Victor-BM/PIBIC-CEFET/Mecânica/PROY_CASTER WHEEL FIXED 8 HEAVY DUTY/Render_Caster.JPG

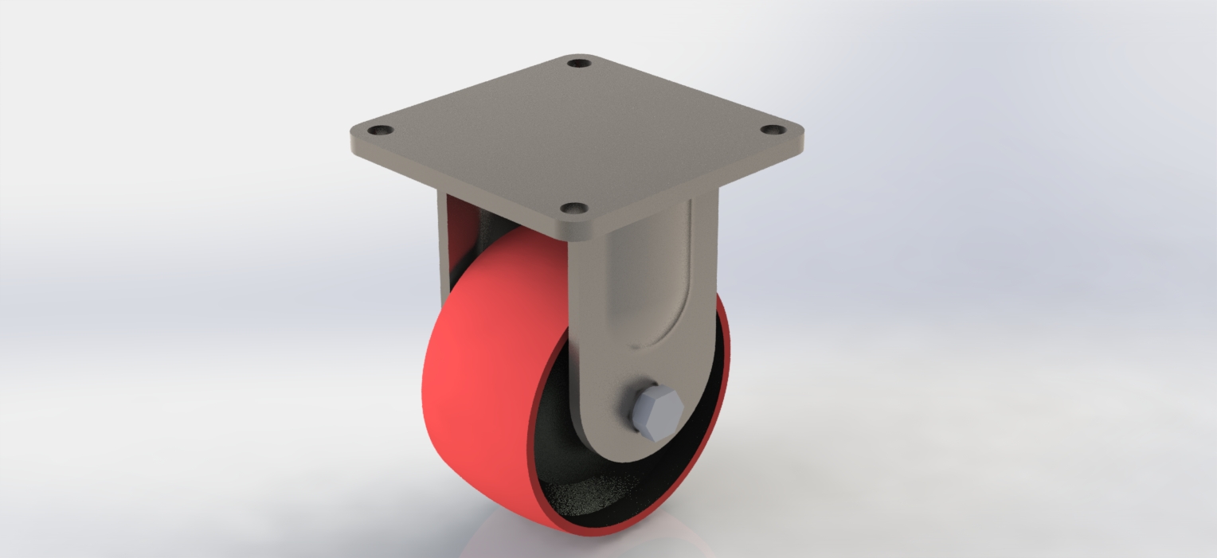
Mecânica/PROY_CASTER WHEEL FIXED 8 HEAVY DUTY/Render_Caster.JPG
