Victor-BM/PIBIC-CEFET/Mecânica/motorreductor v4.png

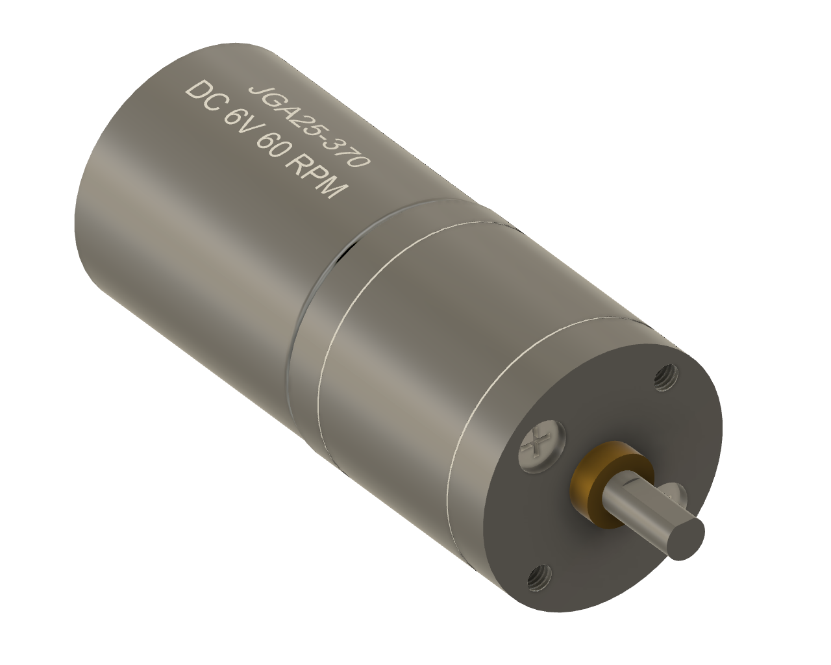
Mecânica/motorreductor v4.png
