Victor-BM/PIBIC-CEFET/Mecânica/motorreductor_1.png

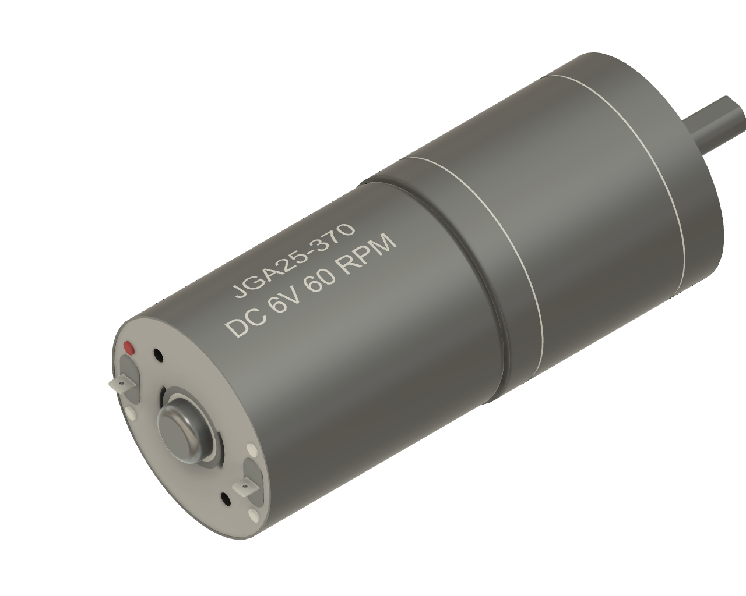
Mecânica/motorreductor_1.png
