Victor-BM/PIBIC-CEFET/Mecânica/PROY_CASTER WHEEL FIXED 8 HEAVY DUTY/Caster with 8.5 x 8.5 Plate.STEP

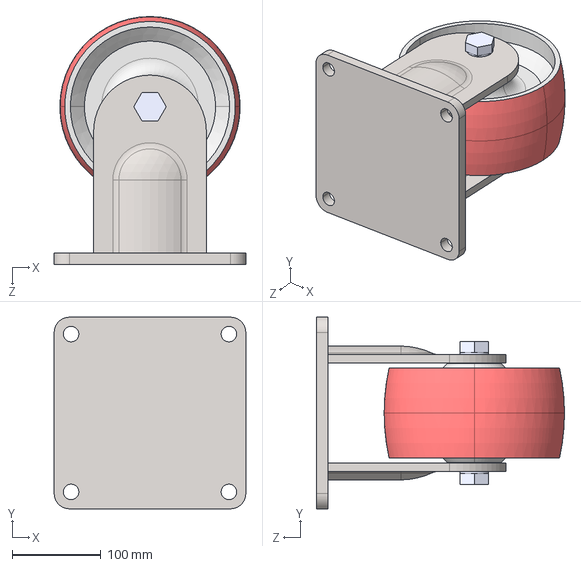
[picture p36: CAD file, 2023-12-13]
Mecânica/PROY_CASTER WHEEL FIXED 8 HEAVY DUTY/Caster with 8.5 x 8.5 Plate.STEP
215.9 x 215.9 x 279.4 mm
