Victor-BM/PIBIC-CEFET/Mecânica/servo motor (mg90s) .stl

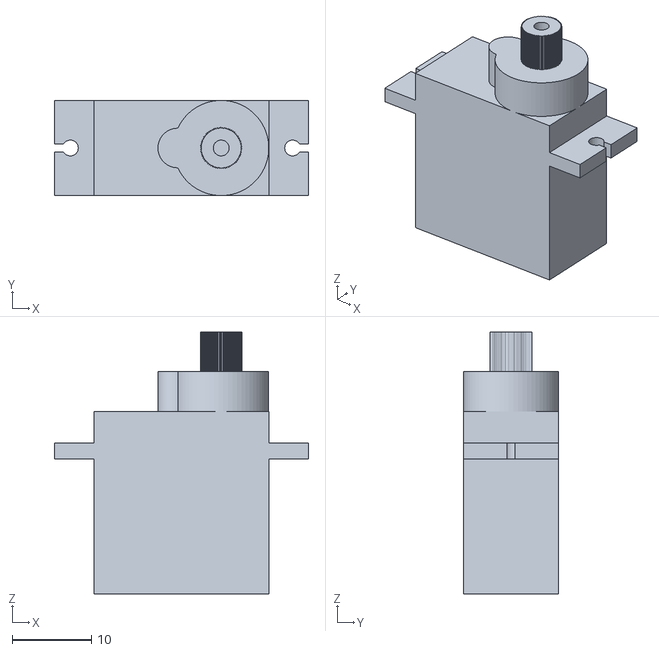
[picture p37: CAD file, 2023-12-13]
Mecânica/servo motor (mg90s) .stl
32.0 x 12.0 x 33.0
