Victor-BM/PIBIC-CEFET/Mecânica/wheel (scaled).SLDPRT

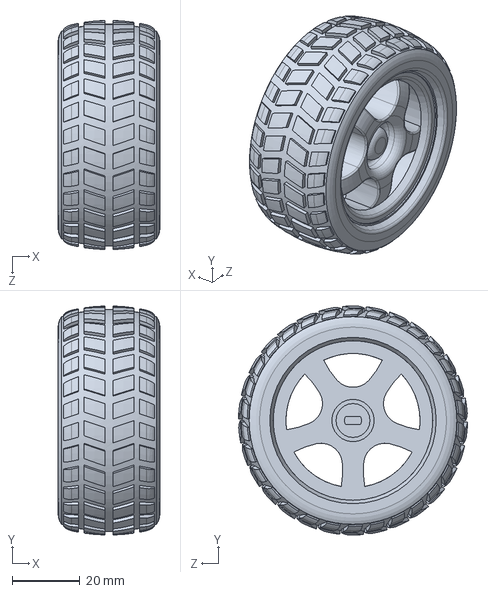
[picture p38: CAD file, 2023-12-13]
Mecânica/wheel (scaled).SLDPRT
30.0 x 67.4 x 67.5 mm
