Victor-BM/PIBIC-CEFET/Mecânica/shaft.SLDPRT

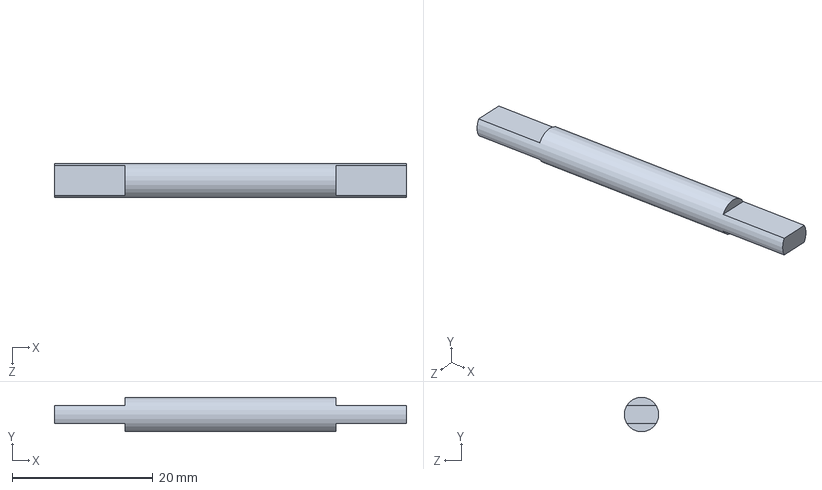
[picture p39: CAD file, 2023-12-13]
Mecânica/shaft.SLDPRT
50.0 x 4.90 x 4.90 mm
