Victor-BM/PIBIC-CEFET/Mecânica/GP2Y0A41SK0F.stp

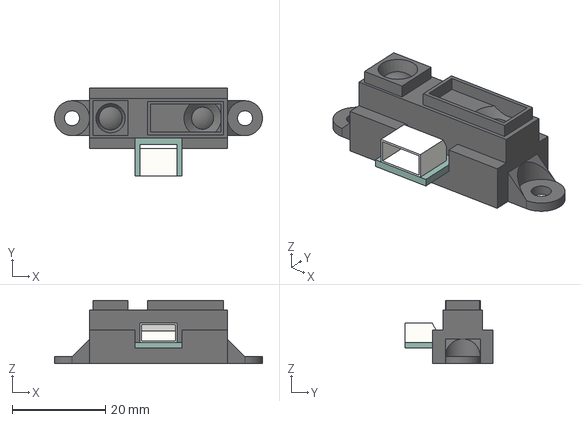
[picture p40: CAD file, 2023-12-13]
Mecânica/GP2Y0A41SK0F.stp
44.5 x 18.9 x 13.5 mm
