Victor-BM/PIBIC-CEFET/Mecânica/motor.SLDPRT

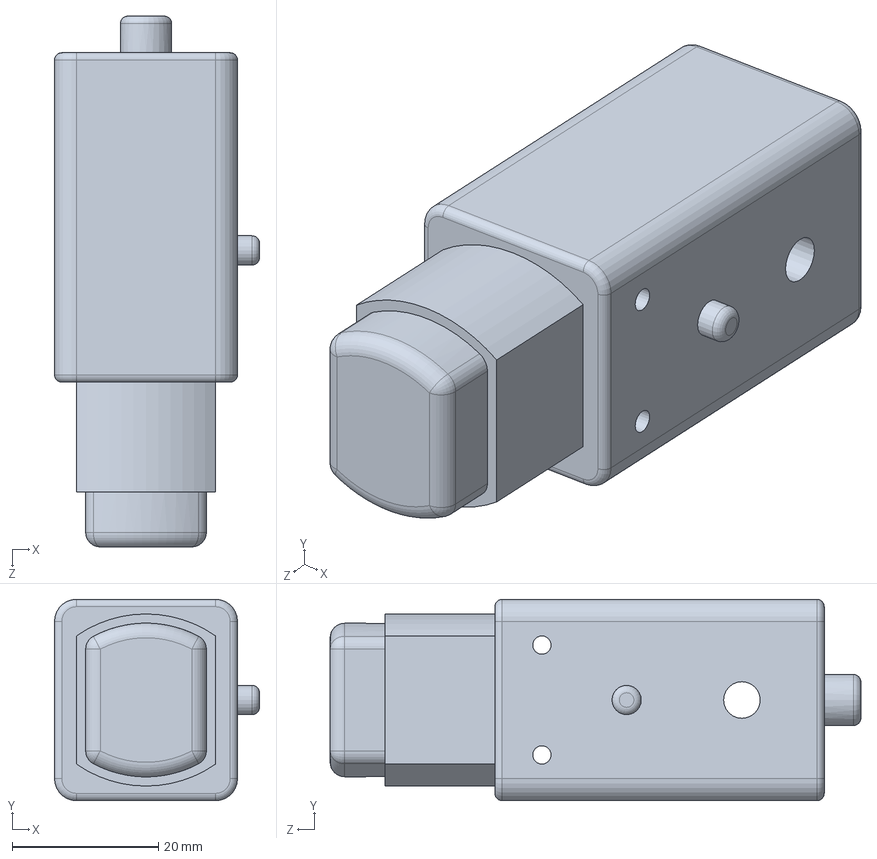
[picture p41: CAD file, 2023-12-13]
Mecânica/motor.SLDPRT
28.0 x 27.5 x 72.5 mm
