Victor-BM/PIBIC-CEFET/Mecânica/JGA25-370 .step

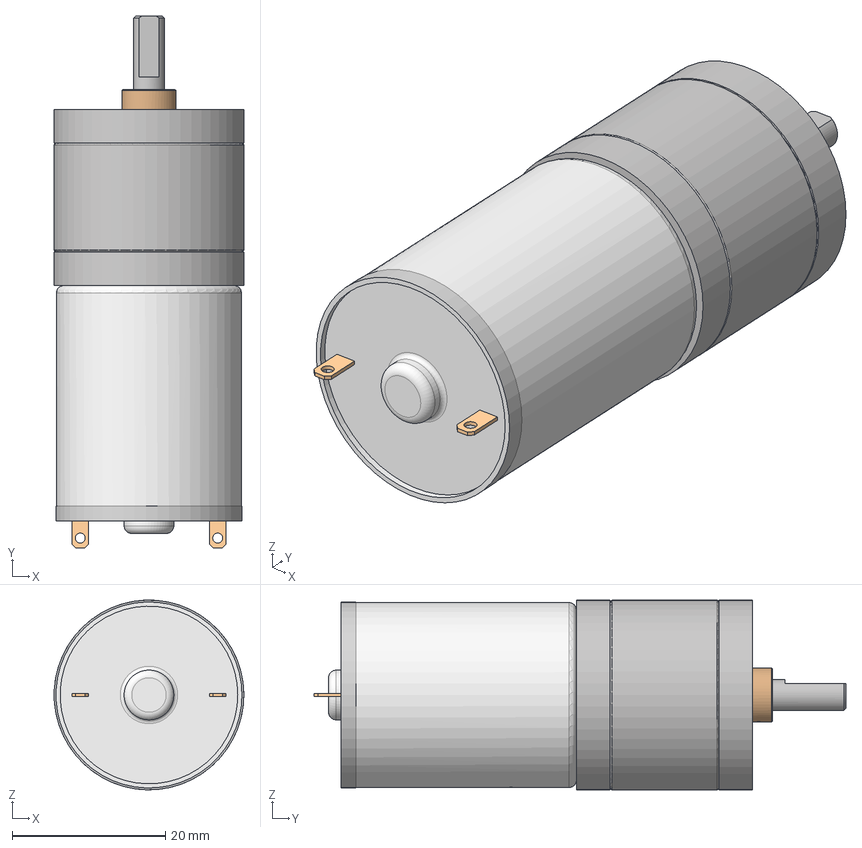
[picture p42: CAD file, 2023-12-13]
Mecânica/JGA25-370 .step
24.8 x 69.5 x 24.8 mm
Motor
Gearbox
90116A027_316 Stainless Steel Pan Head Phillips Screws x 2
