Victor-BM/PIBIC-CEFET/Mecânica/Caster Colson Series 4 5in Swivel and Brake.STEP

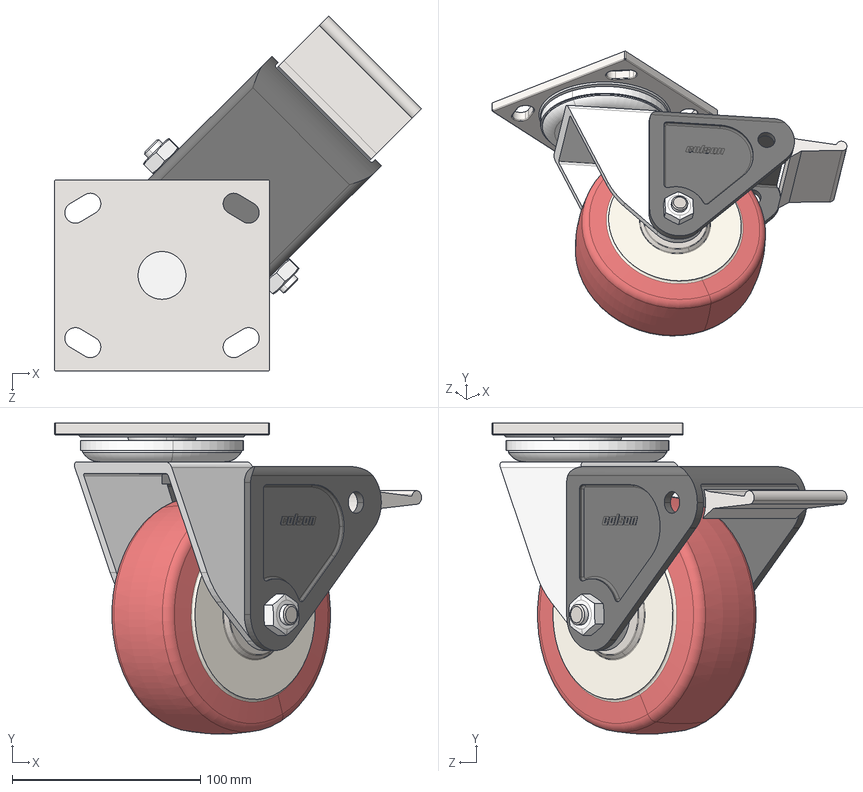
[picture p43: CAD file, 2023-12-13]
Mecânica/Caster Colson Series 4 5in Swivel and Brake.STEP
195.1 x 165.1 x 188.7 mm
Wheel
Bearings Swivel
Brake Housing
Brake
Wheel Housing
Mounting Plate
Nut x 2
