Victor-BM/PIBIC-CEFET/Mecânica/Microservo horn.SLDPRT

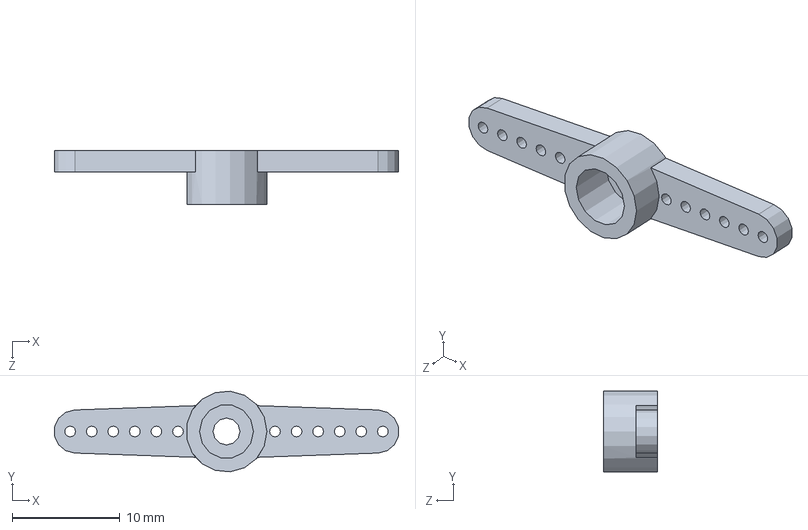
[picture p44: CAD file, 2023-12-13]
Mecânica/Microservo horn.SLDPRT
31.9 x 7.47 x 5.00 mm
