Victor-BM/PIBIC-CEFET/Mecânica/motorreductor v4.step

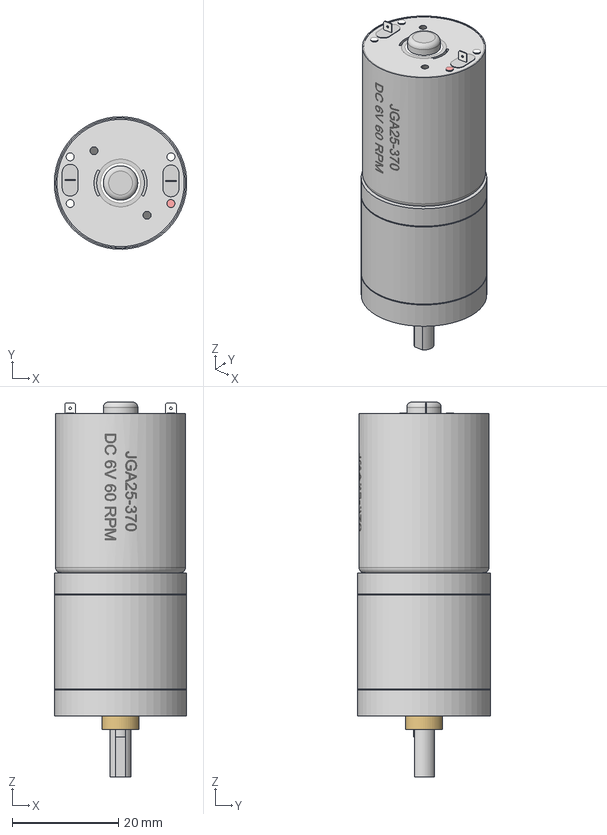
[picture p45: CAD file, 2023-12-13]
Mecânica/motorreductor v4.step
25.0 x 25.0 x 70.7 mm
tornillo_motor x 2
