Victor-BM/PIBIC-CEFET/(list of files, cad)

Other CAD files:
Mecânica/servo motor (mg90s) v1.step
Mecânica/BaseM.ipt
Mecânica/BaseP.ipt
Mecânica/BaseS.ipt
Mecânica/GP2Y0A41SK0F.f3d
Mecânica/GP2Y0A41SK0F/GP2Y0A41SK0F.ipt
Mecânica/Montagizinha.iam
Mecânica/OldVersions/BaseM.0005.ipt
Mecânica/OldVersions/BaseP.0027.ipt
Mecânica/OldVersions/BaseS.0007.ipt
Mecânica/OldVersions/Montagizinha.0018.iam
Mecânica/OldVersions/Suporte.0010.ipt
Mecânica/OldVersions/apoiom.0004.ipt
Mecânica/OldVersions/servo motor (mg90s) .0001.ipt
Mecânica/OldVersions/ultrassom.0002.ipt
Mecânica/PROY_CASTER WHEEL FIXED 8 HEAVY DUTY/Caster with 8.5 x 8.5 Plate.IGS
Mecânica/PROY_CASTER WHEEL FIXED 8 HEAVY DUTY/Caster with 8.5 x 8.5 Plate.SLDPRT
Mecânica/PROY_CASTER WHEEL FIXED 8 HEAVY DUTY/Caster with 8.5 x 8.5 Plate.STL
Mecânica/RodaG.ipt
Mecânica/RodaP.ipt
Mecânica/Suporte.ipt
Mecânica/apoiom.ipt
Mecânica/boba.ipt
Mecânica/esp32_dev_kit_v1_asm/BUTTONFLASH-13_2.ipt
Mecânica/esp32_dev_kit_v1_asm/BUTTONFLASH-14_2.ipt
Mecânica/esp32_dev_kit_v1_asm/BUTTON_R_ASM.iam
Mecânica/esp32_dev_kit_v1_asm/MICROCHIP_2.ipt
Mecânica/esp32_dev_kit_v1_asm/PCB.ipt
Mecânica/esp32_dev_kit_v1_asm/PIN.ipt
Mecânica/esp32_dev_kit_v1_asm/RECTANGULARCHIP_2.ipt
Mecânica/esp32_dev_kit_v1_asm/RESISTOR1_2.ipt
Mecânica/esp32_dev_kit_v1_asm/RESISTOR2-32_2.ipt
Mecânica/esp32_dev_kit_v1_asm/TANCHIP_2.ipt
Mecânica/esp32_dev_kit_v1_asm/TRANSISTOR_3-LEG2_2.ipt
Mecânica/esp32_dev_kit_v1_asm/TRANSISTOR_3-LEG_2.ipt
Mecânica/esp32_dev_kit_v1_asm/USB_SOCKET_2.ipt
Mecânica/esp32_dev_kit_v1_asm/WIFI_CARD_2.ipt
Mecânica/esp32_dev_kit_v1_asm/esp32_dev_kit_v1_asm.iam
Mecânica/motorreductor v4/Component2.ipt
Mecânica/motorreductor v4/Component3.ipt
Mecânica/motorreductor v4/Component4.ipt
Mecânica/motorreductor v4/Component5.ipt
Mecânica/motorreductor v4/Component6.ipt
Mecânica/motorreductor v4/Component7.ipt
Mecânica/motorreductor v4/Component8.ipt
Mecânica/motorreductor v4/OldVersions/Component2.0001.ipt
Mecânica/motorreductor v4/OldVersions/Component3.0001.ipt
Mecânica/motorreductor v4/OldVersions/Component4.0001.ipt
Mecânica/motorreductor v4/OldVersions/Component5.0001.ipt
Mecânica/motorreductor v4/OldVersions/Component6.0001.ipt
Mecânica/motorreductor v4/OldVersions/Component7.0001.ipt
Mecânica/motorreductor v4/OldVersions/Component8.0001.ipt
Mecânica/motorreductor v4/OldVersions/motorreductor v4.0001.iam
Mecânica/motorreductor v4/OldVersions/tornillo_motor v6.0001.ipt
Mecânica/motorreductor v4/Peça19.ipt
Mecânica/motorreductor v4/Peça55.ipt
Mecânica/motorreductor v4/motorreductor v4.iam
Mecânica/motorreductor v4/tornillo_motor v6.ipt
Mecânica/servo motor (mg90s) .ipt
Mecânica/ultrassom.ipt
Mecânica/wheel (scaled)/OldVersions/wheel (scaled).0001.ipt
Mecânica/wheel (scaled)/OldVersions/wheel (scaled).0002.ipt
Mecânica/wheel (scaled)/OldVersions/wheel (scaled).0003.ipt
Mecânica/wheel (scaled)/wheel (scaled).ipt
