Victor-BM/PIBIC-CEFET/Programação/Calibração.xlsx

GP2Y0A02YK0F |  |  | GP2Y0A21YK0F |  |  | GP2YE03
CM | DADO | TENSÃO | CM | DADO | TENSÃO | CM | DADO
1 | 188 | 0.9188660802 | 1 | 374 | 1.827956989 | 1 | 2306
2 | 220 | 1.075268817 | 2 | 358 | 1.749755621 | 2 | 2307
3 | 245 | 1.197458456 | 3 | 562 | 2.746823069 | 3 | 65295
4 | 269 | 1.314760508 | 4 | 624 | 3.049853372 | 4 | 3855
5 | 284 | 1.388074291 | 5 | 648 | 3.167155425 | 5 | 5120
6 | 316 | 1.544477028 | 6 | 649 | 3.172043011 | 6 | 5901
7 | 344 | 1.681329423 | 7 | 641 | 3.132942326 | 7 | 6924
8 | 359 | 1.754643206 | 8 | 594 | 2.903225806 | 8 | 7948
9 | 410 | 2.003910068 | 9 | 540 | 2.639296188 | 9 | 8972
10 | 478 | 2.336265885 | 10 | 501 | 2.448680352 | 10 | 9999
11 | 522 | 2.551319648 | 11 | 460 | 2.248289345 | 11 | 11016
12 | 544 | 2.65884653 | 12 | 426 | 2.082111437 | 12 | 12046
13 | 551 | 2.693059629 | 13 | 397 | 1.940371457 | 13 | 13318
14 | 555 | 2.712609971 | 14 | 374 | 1.827956989 | 14 | 14351
15 | 544 | 2.65884653 | 15 | 351 | 1.715542522 | 15 | 15628
16 | 536 | 2.619745846 | 16 | 331 | 1.617790811 | 16 | 16904
17 | 529 | 2.585532747 | 17 | 311 | 1.520039101 | 17 | 18191
18 | 522 | 2.551319648 | 18 | 296 | 1.446725318 | 18 | 19464
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
