Victor-BM/PIBIC-CEFET/(commit log)

2023-12-13 Update and rename Coordenadas.c to Simulador de Coordenadas.c
2023-12-13 Rename leitorI2C.ino to Leitor I2C.cpp
